TeamWhizzard/EECE-281-Project-1/References/ghost model.jpg

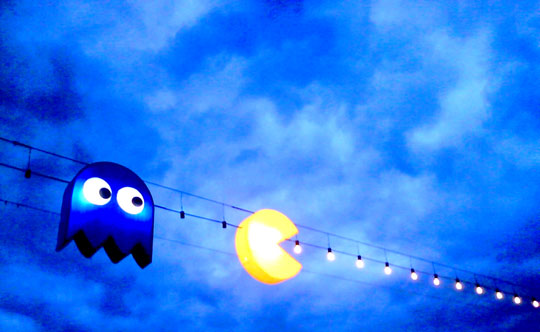
References/ghost model.jpg
