TeamWhizzard/EECE-281-Project-1/Report/Report/Pacman Controller State Machine.png

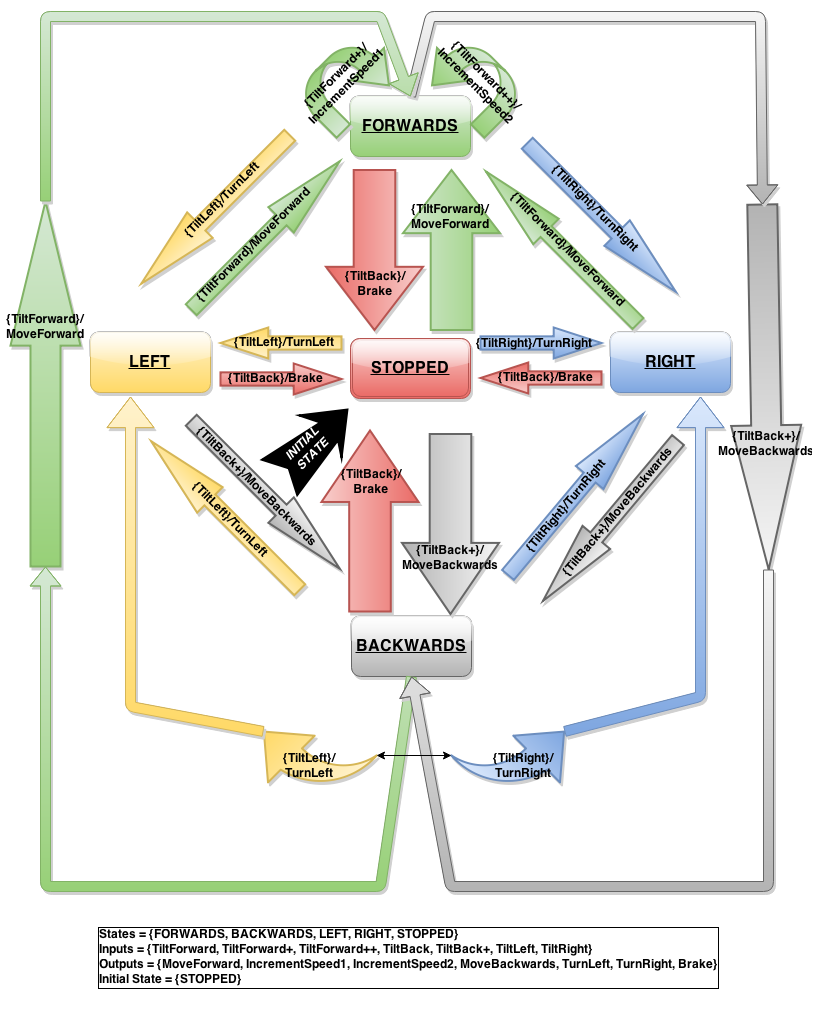
Report/Report/Pacman Controller State Machine.png
