TeamWhizzard/EECE-281-Project-1/Encoder/Assembly.SLDASM

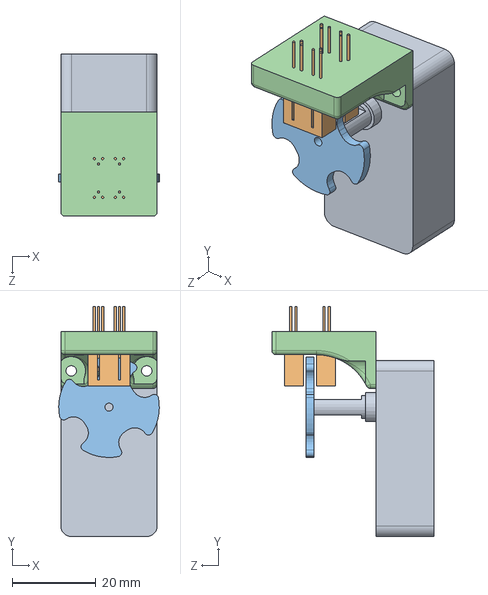
[picture p3: CAD file, 2015-03-10]
Encoder/Assembly.SLDASM
24.0 x 54.9 x 38.7 mm
ErsatzMotor
ErsatzBracket
