TeamWhizzard/EECE-281-Project-1/Encoder Wheel Drawing/16_slot_encoder_black_bg.dxf

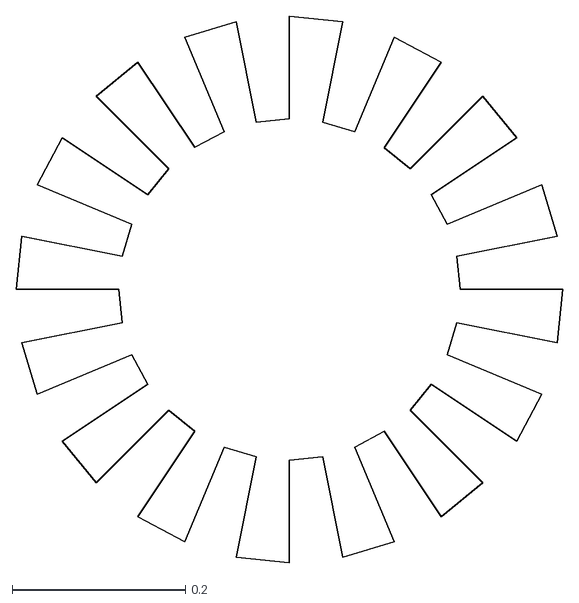
[picture p4: CAD file, 2015-03-12]
Encoder Wheel Drawing/16_slot_encoder_black_bg.dxf
0.63 x 0.63
