TeamWhizzard/EECE-281-Project-1/Encoder/Optointerrupter.SLDPRT

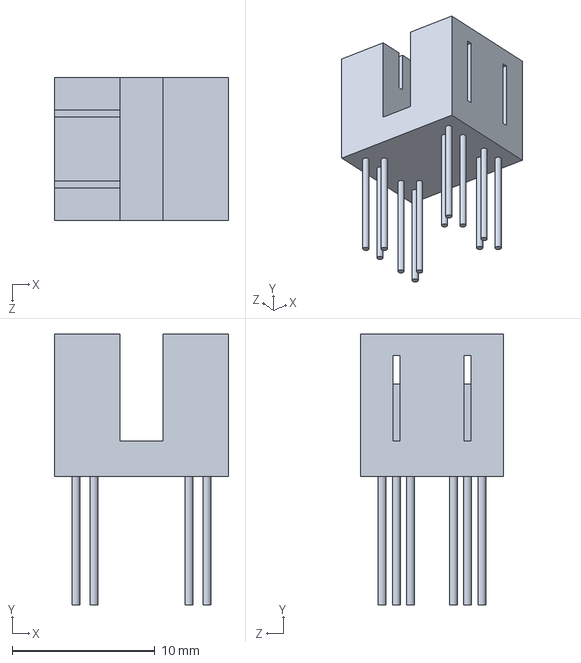
[picture p5: CAD file, 2015-03-10]
Encoder/Optointerrupter.SLDPRT
12.2 x 19.0 x 10.0 mm
