TeamWhizzard/EECE-281-Project-1/Encoder/ErsatzMotor.SLDPRT

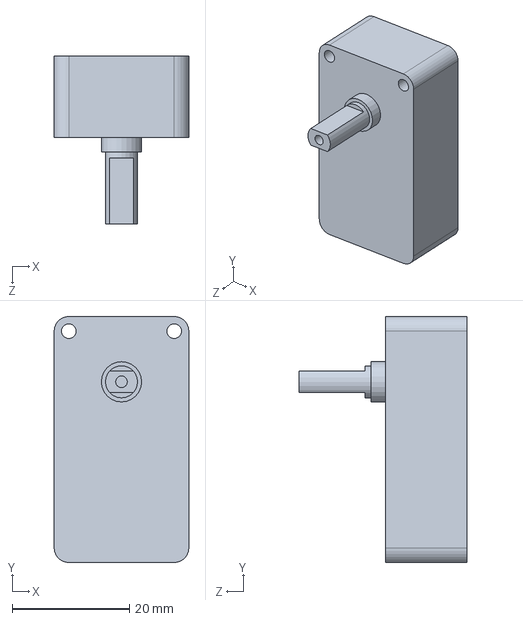
[picture p6: CAD file, 2015-03-10]
Encoder/ErsatzMotor.SLDPRT
23.0 x 42.0 x 28.6 mm
