TeamWhizzard/EECE-281-Project-1/Encoder/EncoderWheel.SLDPRT

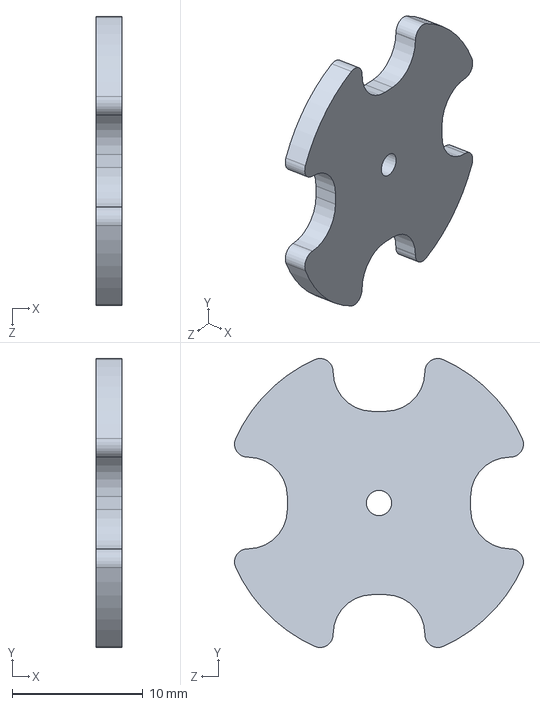
[picture p7: CAD file, 2015-03-10]
Encoder/EncoderWheel.SLDPRT
2.00 x 22.1 x 22.1 mm
