TeamWhizzard/EECE-281-Project-1/Encoder/ErsatzBracket.sldprt

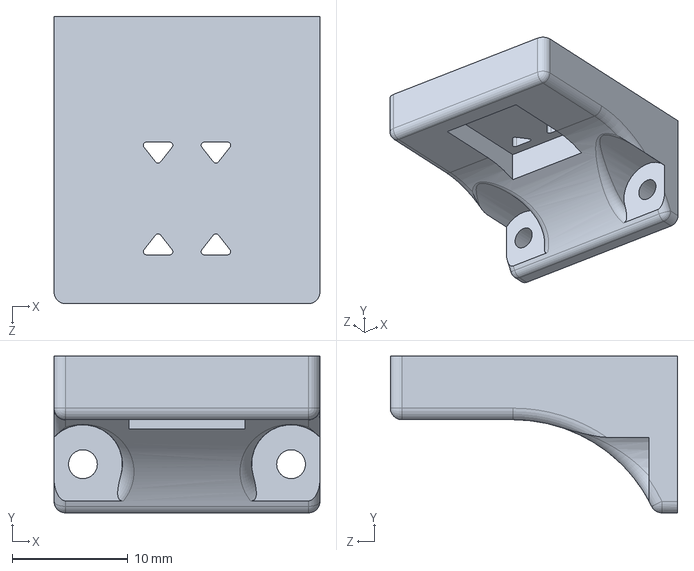
[picture p8: CAD file, 2015-03-10]
Encoder/ErsatzBracket.sldprt
23.0 x 13.6 x 24.9 mm
