TeamWhizzard/EECE-281-Project-1/(list of files, cad)

Other CAD files:
Encoder Wheel Drawing/16_slot_encoder copy.dxf
Encoder/ErsatzBracket.STL
