TeamWhizzard/EECE-281-Project-1/Report/Report/Voltage_and_Current_Testing.txt

Wednesday, March 5th
------------------------------------------------------------------------------------------------

Voltage and Current Testing (Total, Motors, Arduino)
------------------------------------------------------------------------------------------------

************************************************************************************************
Important Specs
************************************************************************************************

Voltage of Batteries = 6.749V

Motor Voltage Specs. = 6V

5 volt logic is 5.024V

Arduino Min Current  = 62 mA
Arduino Max Current = 100 mA

***Arduino Current = 81 +/- 19 mA***
------------------------------------------------------------------------------------------------

************************************************************************************************
Volt Testing
************************************************************************************************

ul Test 1 Right Motor (most stable value seen)

0     =	**Stalled**

25    =	0.778 V

50    =	1.17 V

75    =	1.59 V

100   =	2 V

125   =	2.42 V

150   =	2.86 V

175   =	3.29 V

200   =	3.71 V

225   =	4.17 V

250   =	4.65 V

275   =	5.1 V

300   =	5.5 V

325   =	5.9 V

350   =	6.27 V

375   =	6.43 V

400   =	**Stalled**

Test 2 Left Motor (max value)

0        =	0.252 V

25      =	0.520 V

50      =	1.17 V

75      =	1.58 V

100    =	2.01 V

125    =	2.45 V

150    =	2.89 V

175    =	3.33 V

200    =	3.78 V

225    =	4.25 V

250    =	4.70 V

275    =	5.16 V

300    =	5.58 V

325    =	5.97 V

350    =	6.30 V

375    =	6.42 V

400    =	**Stalled**

Test 3 Right Motor (max value)

0        =	0.265 V

25      =	0.769 V

50      =	1.16 V

75      =	1.57 V

100    =	1.98 V

125    =	2.41 V

150    =	2.84 V

175    =	3.27 V

200    =	3.71 V

225    =	4.28 V

250    =	4.65 V

275    =	5.08 V

300    =	5.55 V

325    =	5.89 V

350    =	6.28 V

375    =	6.40 V

400    =	**Stalled**

************************************************************************************************
Current Testing
************************************************************************************************

Right Motor Current Test (max value)

0        =	0.080 A

25      =	0.088 A

50      =	0.130 A

75      =	0.115 A

100    =	0.128 A

125    =	0.137 A

150    =	0.148 A

175    =	0.157 A

200    =	0.165 A

225    =	0.175 A

250    =	0.185 A

275    =	0.190 A

300    =	0.205 A

325    =	0.210 A

350    =	0.215 A

375    =	0.218 A

400    =	**Stalled**

Left Motor Current Test 1 (max value)

0        =	0.081 A

25      =	0.082 A

50      =	0.096 A

75      =	0.109 A

100    =	0.119 A

125    =	0.125 A

150    =	0.133 A

175    =	0.144 A

200    =	0.156 A

225    =	**Stopped Test**

250    =	**Stopped Test**

275    =	**Stopped Test**

300    =	**Stopped Test**

325    =	**Stopped Test**

350    =	**Stopped Test**

375    =	**Stopped Test**

400    =	**Stopped Test**

Left Motor Current Test Test 2 (max value)

0        =	0.080 A

25      =	0.080 A

50      =	0.093 A

75      =	0.105 A

100    =	0.115 A

125    =	0.125 A

150    =	0.131 A

175    =	0.142 A

200    =	0.148 A

225    =	0.150 A

250    =	0.158 A

275    =	0.160 A

300    =	0.170 A

325    =	0.175 A

350    =	0.179 A

375    =	0.180 A

400    =	**Stalled**

Total Current of everything from DC Power Supply Reading

0        =	0.15 V

25      =	0.16 V

50      =	0.18 V

75      =	0.20 V

100    =	0.22 V

125    =	0.25 V

150    =	0.28 V

175    =	0.30 V

200    =	0.33 V

225    =	0.36 V

250    =	0.39 V

275    =	0.42 V

300    =	0.46 V

325    =	**Left Motor Stalled**

350    =	**********************

375    =	**********************

400    =	**Left Motor Stalled**
