TeamWhizzard/EECE-281-Project-1/Report/Report/Uncalibrated motor line test report.png

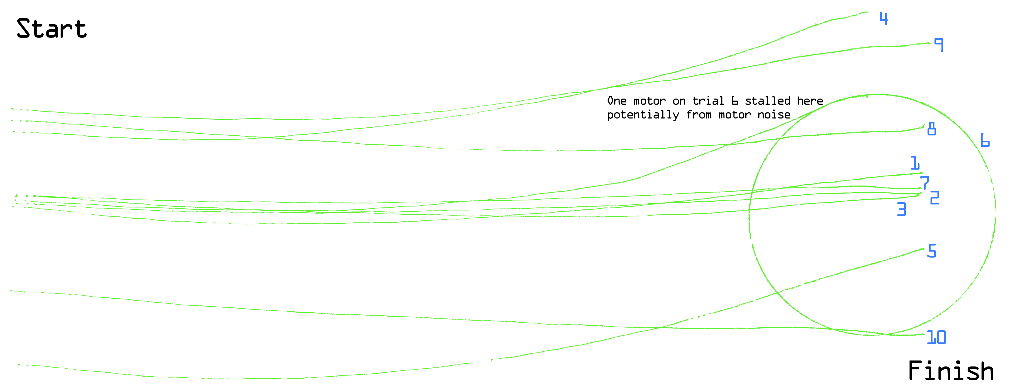
Report/Report/Uncalibrated motor line test report.png
