TeamWhizzard/EECE-281-Project-1/Fritzing/Robot_bb.pdf

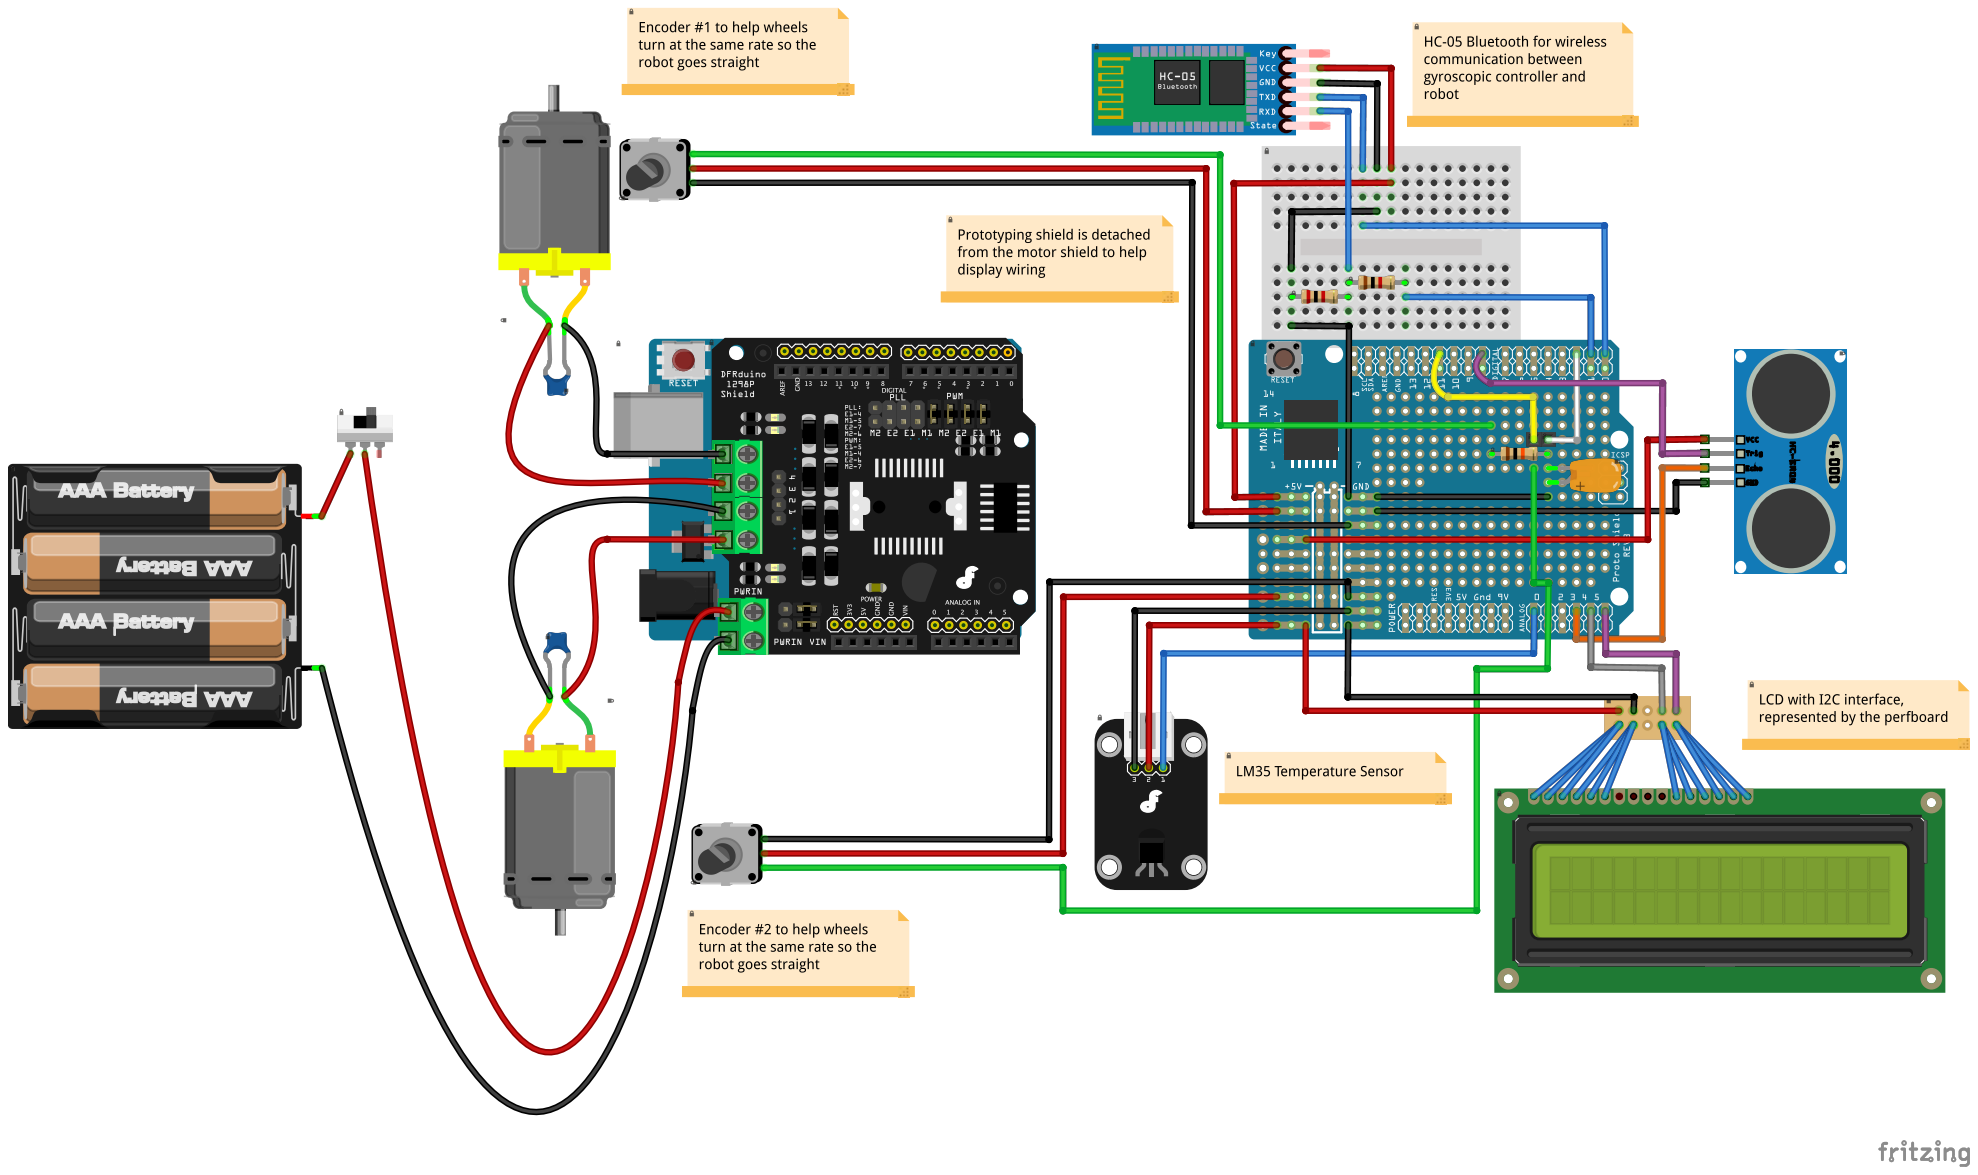
[picture p10: page 1]
