TeamWhizzard/EECE-281-Project-1/(list of files, drawings)

Other design files:
Fritzing/Controller.fzz
Fritzing/Robot.fzz
