TeamWhizzard/EECE-281-Project-1/(commit log)

2015-03-01 Initial Commit with Turtle Demo
    New Motor Shield Library. Commented out code related to pins 6 and 12
    which have been disabled on the shield as we don't need them. Removed
    overridden constructor to trim down code size since we don't change the
    default pin map.
2015-03-02 Added DHT and NewPing libraries, and updated turtle.ino so that it uses the sensor to approach the wall and come to a stop
2015-03-02 Added Pin Map
    Pin Map file is used to track where pins are allocated.
2015-03-03 Added Reference
    DSP and filtering.
2015-03-04 Added turning functions and updated motorControl in an attempt to go straight.
    Comments that were added should give a description of what the additional functions do.
2015-03-05 Added controller sketch
    -Uses gyroscope for turning functionality
    -Added rotate function that uses integration to keep track of net
    degrees turned from center
    -Uses accelerometer for speed up and slow down
2015-03-05 Updated journal and added Voltage and Current Test data that was done today`
2015-03-07 Updated journal and wrote some functions that at this stage are not useful
2015-03-07 Ghost Model
    A sample picture of what our ghost could look like
2015-03-07 Create Interrupt tutorial
2015-03-07 Update controller.ino
    -Improved clarity and control flow in countRotate()
2015-03-07 Update controller.ino
    Added enums to abstract degrees to left, center and right
    Reduces spam of serial print messages by only printing when state changes
2015-03-08 Added controller documentation
    Explained how controller worked with gyroscope and how it affected the robot
    Described the integration process required to keep track of degrees of controller and how it applies to the turning boundary zone
2015-03-08 Update controller.ino
    Attached controller and debugged code accordingly as to fit typical use
    Have to fix center alignment issue if for example user moves 45 degrees left then back right physically, but degrees count not near 0 due to gyroscope data issues
2015-03-08 Added some functions to Extra_Function.ino that control the LED and display distance data and a bar graph
2015-03-08 Properly Imported I2C LCD Library
    Use this code as an example of how to use the I2C LCD Library locally so
    everyone gets the proper code!
2015-03-08 Solidworks Files for Encoder
    Let's see if I'm a caliper wizard today.
    [Assembly.SLDASM, EncoderWheel.SLDPRT, ErsatzBracket.STL, ErsatzBracket.sldprt, ErsatzMotor.SLDPRT, Optointerrupter.SLDPRT]
2015-03-08 Create Angle calculation via Complimentary Filter
2015-03-08 Polished the bracket a littl
    `
    [ErsatzBracket.STL, ErsatzBracket.sldprt]
2015-03-08 Controller works responsively
    Made use of the accelerometer to calculate a secondary angle through 3D trig
    Combined the gyro and accelerometer angle measurements into a complimentary filter for smooth data
    Assuming MP6050 is flat, rotation about the y axis would turn the car
    Clockwise rotation -> turn right, Counterclockwise rotation -> turn left
2015-03-09 Updated turtle.ino
    Deleted unnecessary libraries and code, organized the functions into
    sections, and added new functions that control the motors to account
    for the switch to the romeo board
2015-03-09 Revert "Polished the bracket a littl"
    This reverts commit d19e1b0f06e92197fdedb924f74a28ea76eaa063.
    [ErsatzBracket.STL, ErsatzBracket.sldprt]
2015-03-09 Revert "Revert "Polished the bracket a littl""
    This reverts commit 5f4db9867f8c66cadf6aea2eb466358524f011c4.
    [ErsatzBracket.STL, ErsatzBracket.sldprt]
2015-03-09 Revert "none"
    This reverts commit dabce1e4b7035fc674acdd45ed408957f5da1a26.
    [DualVNH5019MotorShield.cpp]
2015-03-09 Update Report.txt
    Added description about accelerometer readings into angle calculations
    Described complimentary filters to compute the best angle with gyro and accel angle measurements as inputs
2015-03-09 Fixed Retail Encoder Directory
    [turtle.ino]
2015-03-09 Create Full_Controller.ino
    -Has degree tracking implemented
    -Prints to LCD according to serial data
    -Needs to implement tune playing in setup
2015-03-09 Create Full_Controller.ino
    Has degree rotation tracking implemented that is abstracted into L, C, R boundary messages
    Prints to the LCD according to serial data from the motors
2015-03-09 Quadrature Prep
    Prepped ghost sketch for Quadrature encoders. Moved a lot of constant
    variables into #define. Removed Processing directory and file that was
    never needed.
2015-03-09 Working Test Sketch for DF Robot Encoder
    The encoder is quite basic. It uses interrupts combined with
    milliseconds to judge speed of each motor. Updated Journal.
2015-03-09 DFRobot Encoder not working
    Please fix this.
2015-03-10 My first report addition and reference with it.
    Battery reference.
2015-03-10 Full Controller combining all functionalities
    Plays Pacman at setup
    Measures degrees afterwards in a loop to determine turning directions
    Checks for serial data from robot and prints it onto its LCD screen
2015-03-10 Updated Voltage_and_Current_Testing.txt
    Converted it to a .txt file
2015-03-10 New Encoder code
2015-03-10 pid update
2015-03-10 Cleaned up Project and organized files
    Also committed working (but very basic) DF Robot Encoder code.
2015-03-10 motor updates
    [Controller.fzz]
2015-03-10 encoder test updates
    [Controller.fzz, Robot.fzz]
2015-03-11 pid passoff
2015-03-11 Changed forward/stop command to tilt about x axis
    Tilt left -> turn left
    Tilt right -> turn right
    Going from left to right goes through center first, unless going at a fast enough speed
    Tilt back -> stop
    Tilt forward -> same as center command, except goes forward from stop state instead of center state for tilt
    Expected to move controller back to center before issuing another command (as expected anyway, otherwise awkward positions)
2015-03-11 PID Test Successful
    Encoder tick differences control voltage delta. Works!
2015-03-11 PID Control for WhizzardMotor
    First attempt at re-writing WhizzardMotor with PID.
    TODO: Change rest of project to match new function prototypes. (motor
    calls for velocity, instead of left and right)
2015-03-11 Fritzing Controller
    [Controller.fzz]
2015-03-11 Updated Robot.fzz
    Started the robot fritzing
    [Robot.fzz]
2015-03-11 Motor control, I hope!
    ISRs & PID didn't play nice with OO, so I broke them out into the main
    sketch... hopefully it's not too much of a mess.
    [ghost.ino]
2015-03-11 Completed Robot.fzz
    Completed the Fritzing model for the robot and organized the external
    parts into a folder. Also exported the model as a PDF in case of any
    errors or deletions caused by Fritzing
    [Robot.fzz]
2015-03-11 More Fritzing
    [Controller.fzz]
2015-03-11 Fritzing Update
    Controller finished
    [Controller.fzz]
2015-03-11 Commented Robot.fzz
    [Robot.fzz]
2015-03-11 Banshee
    Had a bad time merging PID drive into ghost, so I started banshee to
    drag things from ghost into.
    PID drive for wheels works. Pings with no time-wasting waiting (using
    timer interrupts) work.
    Doesn't work in order of priority:
    * PID wall approach (needs filtering?)
    * Turning / reverse motor control
    * LCD output on turtle
    * Bluetooth connection
    [DualVNH5019MotorShield.cpp]
2015-03-11 robot sketches prior to wheel break. Theresa is going to sleep now.
2015-03-12 Higher Resolution Encoder Wheel + references
    References pertaining to pin noise solution. Also added a 16 slot
    encoder wheel that the DF Robot sketch is apparently compatible with.
    [16_slot_encoder copy.dxf, 16_slot_encoder_black_bg.dxf]
2015-03-12 Added gyroscope left turn
2015-03-12 Updated Robot.fzz Fritzing
    [Robot.fzz]
2015-03-13 Fritzing for Robot
    [Robot.fzz]
2015-03-13 Updated Robot.fzz
    [Robot.fzz]
2015-03-13 Revert "integrated banshee code final (yay!)"
    This reverts commit 1c02c64943ec258b646f4b84606e340eddad6c60.
    [Controller.ino, DualVNH5019MotorShield.cpp, Encoder.ino]
2015-03-13 Added controller state machine
    Made a flowchart of the state machine for the controller
2015-03-15 Finalized Arduino sketches
    [16_slot_encoder copy.dxf, 16_slot_encoder_black_bg.dxf]
